MuakTiger/tactile-vision/logs/compare/20260928_132213_181_indoor.png

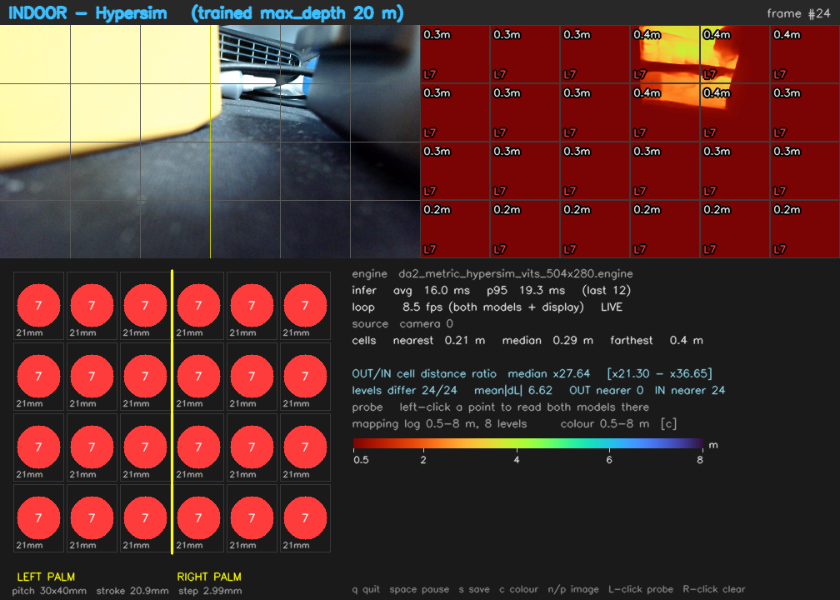
logs/compare/20260928_132213_181_indoor.png
