MuakTiger/tactile-vision/logs/compare/20260928_132213_873_outdoor.png

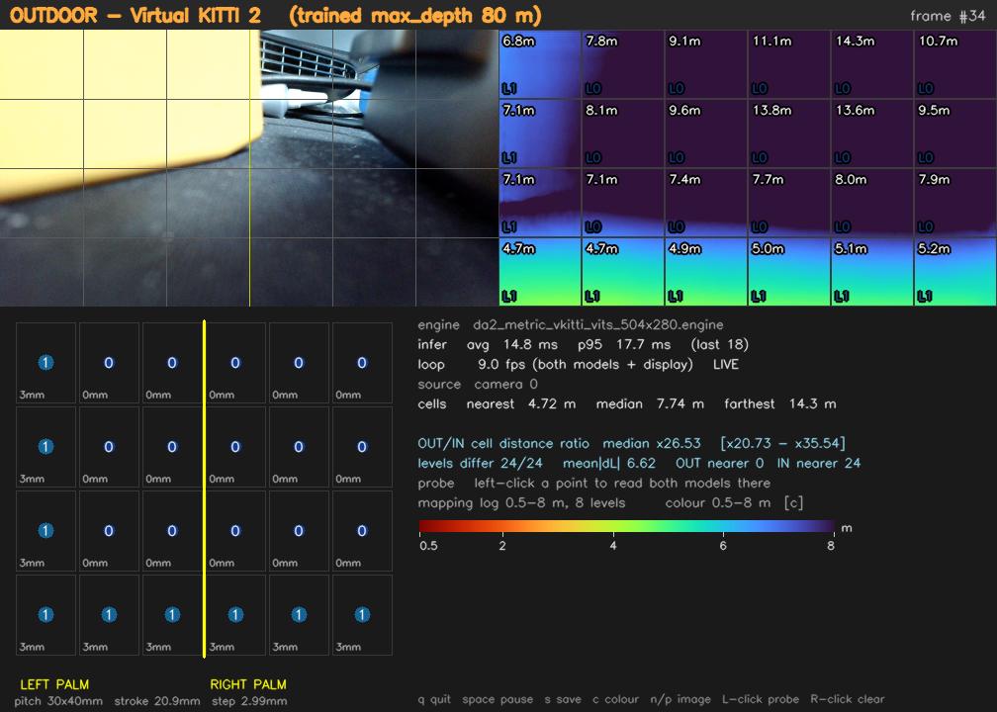
logs/compare/20260928_132213_873_outdoor.png
