MuakTiger/tactile-vision/docs/experiment_notebook_2026-10.html

졸업논문 실험 · 10/15(목) ~ 10/17(토) · 제출 10/20(화)

# 촉각비전 실험 노트

반응 시간, 거리, 핀 영점, 보행 실험의 준비물·절차·명령어·기록 형식을 날짜 순서로 모았어요. 체크 표시는 이 기기의 브라우저에만 남아요.

## 일정

언제 | 할 일 | 완료 기준
목 낮 | 교수님 메일, 토요일 보조자·장소, 주문·구입 | 메일 발송, 보조자 확정
목 20:00~ | 반응 시간 | 슬로모션 원본 3개(30회), 로그 사본
금 오후 17:30 전 | 거리 (실내·실외) | 실내·실외 각 6거리 사진
금 저녁 | 핀 영점, 토요일 준비 | 기록 240줄, 보정 파일 저장, SSH 연습
토 | 정지 감지, 보행 18회 | 정지 로그 20개, 기록표 18줄
일~화 | 분석·작성 | 10/20 제출

- 설정은 그대로 둬요. 토요일까지 바꾸는 건 핀 보정 파일 하나뿐이에요. 단계 수·필터·거리 범위는 손대지 않아요.
- 원본은 지우지 않아요. 영상·사진·로그는 날짜별 폴더에 그대로 둬요.
- 눈을 가리고 걸을 때는 보조자가 꼭 옆에 있어야 해요.

목 낮 · 수업 중과 하교길

## 연락과 준비물

- 지도교수님께 확인 메일 보내기 — 1인 보행 실험의 IRB 처리, 양식 1번의 분량·제출 형식
- 토요일 보조자 1명 확정 — 시간과 장소까지
- 토요일 복도 확정 — 10 m × 2.4 m 안팎, 계단·문턱 없는 곳, 사용 허락
- 디지털 캘리퍼스 주문 — 금속 몸체, 0.01 mm 표시, 깊이 막대가 있는 것. 금요일 저녁 전에 받을 수 있게
- 접이식 흰지팡이 주문 — 토요일 전에 못 받으면 곧은 막대(명치 높이, 약 120~130 cm)로 대신하고 그렇게 적어요
- 줄자 5 m 이상
- 골판지 큰 것 여러 장, 빈 상자 높이 45 cm 안팎
- 검은 종이나 검은 매직, 마스킹테이프, 끈, 수면 안대

목 20:00~ · 집 · 혼자

## 반응 시간 엔드투엔드

판이 카메라 앞에 나타나거나 사라진 뒤, 핀이 움직이기 시작하기까지와 목표 높이에 닿기까지 걸린 시간을 240 fps 영상으로 잽니다.

완료 기준슬로모션 원본 3개(10회씩, 모두 30회), 로그 사본 1개, 메모(벽까지 거리, 시작 단계)

### 준비물

- 장치 일체 — LiPo 2개와 보조배터리 충전
- 검은 판 40×60 cm와 끈 — 골판지에 검은 종이를 붙이거나 매직으로 칠해요
- 아이폰(슬로모션 240 fps)과 폰 거치대
- 30 cm 자, 기준선을 표시할 막대, 마스킹테이프

왼손

012678121314181920

오른손

34591011151617212223

장치 화면의 24칸. 재는 핀은 칸 9예요. 화면에서 위로부터 둘째 줄, 왼쪽부터 넷째 칸(오른손 첫 열)이에요. 0.5 m 앞에서 이 칸의 위쪽 경계는 렌즈보다 약 9 cm 높아요.

### 절차

1. 장치 점검
  시험 다섯 묶음이 모두 통과하고 핀이 한 번 오르내리면 돼요. 마지막 줄(코드 버전)은 메모해요.

cd ~/tactile-vision
PY=~/sensory_substitution/venv/bin/python
for t in tools/test_mapping.py tools/test_protocol.py tools/test_scene.py tools/test_switch.py tools/test_firmware.py; do $PY -B $t | tail -1; done
$PY -B tools/servo_updown_test.py --cycles 1
git log -1 --format='%h %ad %s' --date=short
  복사
2. 장치와 판 놓기
  장치를 책상에 고정하고 카메라가 먼 벽을 보게 해요. 벽까지 4 m 이상이면 가운데 칸이 단계 0에서 시작해요. 더 가까우면 시작 단계만 메모하면 돼요.
  판은 끈에 매달아, 떨어뜨리면 렌즈 앞 0.5 m에서 화면 가운데를 가리고 멈추게 끈 길이를 맞춰요.
3. 0 ms 기준선 표시
  판이 지나가는 옆에 막대를 세우고 렌즈 높이 + 9 cm에 테이프를 붙여요. 판 아래 끝이 이 선을 지나는 프레임이 0 ms예요. 내릴 때와 올릴 때 같은 선을 써요. 막대는 장치 카메라 화면 밖에 둬요.
4. 폰 놓기
  슬로모션(240 fps)으로 두고, 패드 뒤 위쪽에서 패드 너머로 판이 보이게 고정해요. 칸 9 핀이 크게 보이고 판 아래 끝과 기준선이 같은 화면에 들어오면 돼요. 핀 옆에 자를 세우고 조명은 밝게 해요.
5. 장치 실행 (확인 화면 없이)
  핀이 움직여요. 손을 패드에서 떼세요.

$PY -B run.py
  복사
6. 녹화 1 — 10회
  녹화 시작 → [판 내리기 → 3초 → 판 올리기 → 5초] × 10 → 녹화 정지
7. 녹화 2 — 10회
  같은 방법으로 10회.
8. 녹화 3 — 10회
  같은 방법으로 10회.
9. 끄고 로그 복사
  터미널에서 Ctrl+C를 누르면 핀이 천천히 내려가요. 그다음 로그를 다른 이름으로 복사해요.

cp logs/metrics.csv logs/metrics_$(date +%m%d_%H%M)_latency.csv
  복사
10. 영상 원본 옮기기, 메모
  케이블로 아이폰의 원본 파일(DCIM 폴더)을 그대로 복사해요. 일반 속도로 변환된 파일은 쓰지 않아요.
  메모: 벽까지 거리, 시작 단계, 설정은 '보정 전(24칸 372/232)'.

#### 주의

- 확인 화면(--debug)을 켜면 초당 9.4프레임으로 느려져요. 이 실험은 화면 없이 해요.
- run.py는 실행할 때마다 logs/metrics.csv를 새로 써요. 끝나면 바로 복사해요.
- 핀 영점 보정 전에 재도 괜찮아요. 영점과 최대를 같은 만큼 옮기는 보정이라 움직이는 시간은 그대로예요.

금 오후 · 해 지기 전(17:30까지) · 혼자 가능

## 거리 정확도

장치 카메라로 찍은 사진에서 모델이 추정한 거리를, 줄자로 잰 실제 거리와 비교합니다. 같은 사진에 실내·실외 모델을 둘 다 돌려 모델별 배율을 구해요. 분석은 사진만 있으면 나중에 할 수 있어요.

완료 기준실내 6거리 + 실외 6거리, 거리마다 숫자 종이 1장 + 판 3장 (모두 48장)

### 준비물

- C920(장치에 달린 그 카메라)과 노트북
- 판 50×70 cm 이상 — 무늬 없는 골판지 면
- 줄자, 마스킹테이프, 거리 숫자 종이(0.5 · 1 · 1.5 · 2 · 3 · 4 · 6 · 8)
- 카메라를 1.0 m 높이에 둘 받침 — 의자 위에 상자를 쌓아도 돼요

### 절차

1. 카메라 설정
  C920을 노트북에 꽂고 윈도 카메라 앱의 Pro 모드에서 초점을 가장 먼 쪽 끝으로 고정해요. 자동 초점은 끄고, 사진 비율은 16:9(1280×720 또는 1920×1080)로 해요.
  촬영하는 동안 초점은 건드리지 않아요. 가까운 판이 조금 흐린 건 정상이에요. 장치도 같은 초점이에요.
2. 카메라 놓기
  렌즈 높이 1.0 m, 수평, 정면. 렌즈 바로 아래 바닥을 0으로 하고 거리마다 바닥에 테이프를 붙여요. 거리는 렌즈 앞면에서 판 앞면까지예요.
3. 실내 (복도) — 0.5 · 1 · 1.5 · 2 · 3 · 4 m
  거리마다 숫자 종이를 판에 대고 1장 → 종이를 떼고 판만 3장. 사진 사이에는 판을 들었다가 다시 놓아요. 판 가운데가 렌즈 높이에 오고 카메라를 똑바로 보게 해요.
4. 실외 (넓은 보도·광장) — 1 · 2 · 3 · 4 · 6 · 8 m
  같은 방법으로 찍어요. 판이 바람에 흔들리지 않게 잡아 두세요.
5. 정리
  실내·실외 폴더로 나누고 장소, 시각, 날씨를 메모해요. 보조자가 있으면 실외에서 판 대신 사람이 같은 거리에 서서 3장씩 더 찍어요(선택).

#### 주의

- 꼭 장치의 C920으로 찍어요. 다른 카메라는 화각이 달라서 거리 배율도 달라져요.
- 판이 작으면 먼 거리에서 칸 넓이의 10%를 못 채워, 장치가 쓰는 칸 대표 거리에 잡히지 않아요. 50×70 cm보다 작게 하지 않아요.
- 10/12~13에 찍은 영상은 실제 거리 기록이 없으면 쓰지 않아요.
- 노트북에서 초점이 고정되지 않으면 실내만 젯슨과 모니터로 찍어 두세요(s 키로 저장, 초점 0 자동 고정). 실외 방법은 그다음에 정해요.

cd ~/tactile-vision
~/sensory_substitution/venv/bin/python -B tools/cam_raw.py --size 1280x720

복사

금 저녁 · 집 · 혼자

## 핀 영점 보정

같은 지령에서 24핀의 높이가 얼마나 다른지 재고, 핀마다 영점 tick을 옮겨 맞춘 뒤 다시 잽니다.

완료 기준보정 전·후 각각 24핀 × 단계 0·7 × 5회 (기록 240줄), 보정 파일 저장과 백업

### 준비물

- 디지털 캘리퍼스 — 켜고 턱을 닫은 상태에서 0으로 맞추기
- 기록지 2장(보정 전·후) — 핀 0~23 줄, 5회 × (단계 0, 단계 7) 칸

### 재는 법

핀이 튀어나왔을 때 (+)

캘리퍼스를 세워 본체 끝면을 핀 윗면에 얹고, 깊이 막대를 핀 바로 옆 패드 표면까지 내려 읽어요.

핀이 패드보다 낮을 때 (−)

끝면을 패드 표면에 얹고 깊이 막대를 핀 윗면까지 내려 읽은 뒤 −를 붙여요.

매번 같은 자세로, 0번부터 23번까지 같은 순서로 재요.

### 절차

1. 보정 파일 백업

cd ~/tactile-vision
PY=~/sensory_substitution/venv/bin/python
cp calib/servo_calib.json calib/servo_calib_backup_$(date +%m%d_%H%M).json
  복사
2. 보정 전 측정 — 5회
  24칸을 공통값(372/232)으로 움직여요. 보정 파일은 건드리지 않아요. 핀이 내려가 있는 6분 동안 24핀(단계 0)을, 올라가 있는 6분 동안 24핀(단계 7)을 재요. 이걸 5번 반복해요.

$PY -B tools/servo_updown_test.py --home 372 --span 140 --cycles 5 --hold 360
  복사
3. 핀마다 영점 맞추기

$PY -B tools/calibrate_pins.py --step 1
  복사
  n p
  다음·이전 채널 (또는 0~9, a~n로 바로 고르기)
  g
  영점 위치로 이동 → 캘리퍼스로 재기
  k j
  1 tick씩 이동. 역방향 조립이라 k는 핀이 내려가고 j는 올라가요
  h
  0.00 mm(±0.05)가 되면 영점 저장. 누른 키와 횟수를 적어 둬요
  G → m
  최대 위치로 가서 같은 키를 같은 횟수만큼 누른 뒤 최대 저장. 스트로크가 그대로 유지돼요
  t
  24칸을 다 하면 전체 스윕으로 눈 확인
  s → q
  저장하고 끝내기
4. 보정 후 측정 — 5회
  이번에는 저장한 보정 파일 값으로 움직여요. 재는 방법은 2번과 같아요.

$PY -B tools/servo_updown_test.py --cycles 5 --hold 360
  복사
5. 기록지 사진
  보정 전·후 두 장을 찍어 둬요. 나중에 분석용 CSV(phase, pin, rep, zero_mm, top_mm, home_tick)로 옮겨요.

#### 주의

- 핀이 움직이는 동안 손을 패드에 두지 않아요.
- 최대 위치를 옮길 때 기어가 걸리는 소리가 나면 멈추고, 그 칸은 메모만 해요.
- 6분 안에 24핀을 다 못 재면 --hold 값(초)을 늘려요.

### 토요일 준비 (같은 날 밤)

- SSH 연습 — 젯슨과 노트북을 휴대폰 핫스팟에 연결 → 젯슨에서 hostname -I로 IP 확인 → 노트북 PowerShell에서 ssh june@IP. 접속되면 성공
- 장애물 ① 빈 상자 (높이 45 cm)
- 장애물 ② 사람 크기 판 (골판지, 높이 170 cm × 폭 45 cm, 넘어지지 않게 받침)
- 장애물 ③ 머리 높이 판 (골판지 약 60×40 cm, 아랫면 145 cm) — 매달 방법까지 정하기. 지팡이에 걸리는 받침이 없어야 해요
- 장애물 ④ 의자
- 수면 안대, 흰지팡이(또는 막대), 초시계(휴대폰)
- 배터리 충전 — LiPo 2개, 보조배터리, 노트북, 휴대폰

토 · 복도 · 보조자 1명

## 1인 장애물 보행

눈을 가리고 10 m 코스를 걸을 때 지팡이만(C), 장치만(D), 둘 다(C+D) 쓴 경우의 완주 시간과 충돌을 비교합니다. 그 전에, 걷지 않고 선 채로 장애물마다 장치가 몇 단계로 표시하는지 잽니다.

완료 기준정지 감지 로그 20개, 보행 18회 기록표, 묶음 로그 2개, 영상, 사진(장치 착용·코스)

참여자 (본인)

안대, 장치 착용, 걷기

보조자

배치 바꾸기, 초시계, 뒤따르며 촬영, 위험하면 멈춰 세우기

### 코스와 배치

폭 2.4 m, 길이 10 m. 출발선·도착선과 2.5 · 4.5 · 6.5 · 8.5 m 위치를 바닥에 테이프로 표시해요. 복도가 짧거나 좁으면 비율대로 줄이고 실제 크기를 적어요.

배치 | ① 상자 | ② 사람 판 | ③ 머리 판 | ④ 의자
L1 | 2.5 m 왼쪽 | 4.5 m 가운데 | 6.5 m 오른쪽 | 8.5 m 오른쪽 벽
L2 | 4.5 m 오른쪽 | 8.5 m 왼쪽 | 2.5 m 가운데 | 6.5 m 왼쪽 벽
L3 | 6.5 m 가운데 | 2.5 m 오른쪽 | 8.5 m 왼쪽 | 4.5 m 오른쪽 벽

L1

L2

L3

왼쪽·오른쪽은 걷는 사람 기준이에요. 그림의 위쪽 벽이 왼쪽 벽이고, 점선 테두리(③)는 매달린 판이에요.

### 진행 순서

1. 코스 설치
  바닥에 테이프로 표시하고, L1 배치를 한 번 놓아 봐요.
2. 젯슨 접속
  노트북에서 SSH로 접속한 뒤:

cd ~/tactile-vision
PY=~/sensory_substitution/venv/bin/python
  복사
3. 정지 감지 시험 (약 30분, 걷지 않음)
  장애물 하나를 코스 가운데에 두고, 장치를 착용한 채 장애물 앞 4 · 3 · 2 · 1.5 · 1 m에 서서 8초씩 실행해요. 핀은 움직이지 않아요. 위치마다 로그를 바로 복사해요.

$PY -B run.py --no-hw --duration 8
cp logs/metrics.csv logs/static_box_4m.csv
  복사
  파일 이름의 장애물(box · panel · head · chair)과 거리를 바꿔 가며 20번 해요. 예: static_head_1.5m.csv

장애물 | 4 m | 3 m | 2 m | 1.5 m | 1 m
① 상자box
② 사람 판panel
③ 머리 판head
④ 의자chair

4. 기준 속도
  눈을 뜨고 장애물 없이 3번 걸어요. 세 시간의 평균이 기준 시간(baseline_s)이에요.
5. 연습 (코스 밖에서)
  지팡이 이점 접촉법 10분, 장치 10분, 둘 다 5분. 실제로 연습한 시간을 적어요.
6. 장치 켜고 묶음 1 (1~9번)
  이렇게 켜면 SSH가 끊겨도 계속 돌아요.

setsid -f nohup $PY -B run.py > /tmp/tv_run.log 2>&1 < /dev/null
  복사
7. 쉬는 동안 끄고 로그 복사

kill -TERM $(pgrep -f '[r]un\.py'); sleep 3
cp logs/metrics.csv logs/exp3_block1.csv
  복사
8. 다시 켜고 묶음 2 (10~18번), 끝나면 끄고 복사

setsid -f nohup $PY -B run.py > /tmp/tv_run.log 2>&1 < /dev/null
# 18번까지 끝나면
kill -TERM $(pgrep -f '[r]un\.py'); sleep 3
cp logs/metrics.csv logs/exp3_block2.csv
  복사
9. 마무리 사진
  장치를 착용한 모습, 코스 전경, 기록표.

### 한 번의 시행

1. 참여자는 안대를 쓰고 출발선 뒤에서 벽 쪽을 보고 서 있어요. 배치를 보지 않아요.
2. 보조자가 순서표의 배치로 장애물을 옮기고, 조건에 맞게 지팡이를 주거나 거둬요.
3. "출발" — 보조자가 초시계를 누르고 뒤따르며 촬영해요.
4. 몸이 도착선을 넘으면 "도착" — 초시계를 멈춰요.
5. 장애물별 충돌을 적어요. 몸이나 장치가 닿으면 1회, 보조자가 멈춰 세워도 1회예요. 지팡이 끝이 닿은 건 세지 않아요.
6. 30초 쉬고 다음 시행으로 넘어가요.

C+D에서 손: 지팡이는 주로 쓰는 손에, 다른 손 손바닥은 패드에 두고 필요하면 좌우로 옮겨 훑어요. 정한 방법을 그대로 적어요.

### 시행 순서표

완료 | 순서 | 배치 | 조건
묶음 1
| 1 | L2 | C+D둘 다
| 2 | L1 | C지팡이만
| 3 | L3 | D장치만
| 4 | L2 | C지팡이만
| 5 | L3 | C+D둘 다
| 6 | L1 | D장치만
| 7 | L3 | C지팡이만
| 8 | L2 | D장치만
| 9 | L1 | C+D둘 다
묶음 2
| 10 | L3 | D장치만
| 11 | L2 | C지팡이만
| 12 | L1 | D장치만
| 13 | L3 | C지팡이만
| 14 | L2 | C+D둘 다
| 15 | L1 | C지팡이만
| 16 | L3 | C+D둘 다
| 17 | L2 | D장치만
| 18 | L1 | C+D둘 다

같은 배치나 같은 조건이 연달아 나오지 않게 미리 무작위로 정한 순서예요. 묶음마다 조건 3가지 × 배치 3가지가 한 번씩 들어 있어요.

### 기록표 (종이)

순서 | 배치 | 조건 | 시간(초) | ① 상자 | ② 사람 판 | ③ 머리 판 | ④ 의자 | 벽 | 메모
예 | L2 | C+D | 38.4 | 0 | 0 | 1 | 0 | 0 | 칸 쓰는 법 예시

분석할 때 쓰는 열: participant(P1), cond(cane · device · cane_device), block, trial, layout, time_s, col_low(①), col_panel(②), col_head(③), col_side(④), col_wall(벽), baseline_s

#### 안전

- 보조자는 늘 1 m 안에서 뒤따르고, 멈춤 신호("정지")를 미리 정해요.
- 장애물은 가벼운 골판지로 해요. 머리 높이 판은 부딪히면 밀려나게 끈으로 매달고 모서리는 테이프로 감싸요.
- 장치만(D) 쓸 때는 지팡이가 없어 45 cm 상자에 걸려 넘어질 수 있어요. 보조자가 특히 가까이 붙어요.
- 시작 전에 LiPo 전압과 배선을 확인하고, 뜨거워지면 바로 멈춰요.
- IRB 답이 '안 된다'면 정지 감지 시험만 하고 보행은 하지 않아요.

## 기록 규칙

- 원본(영상·사진·로그)은 지우거나 덮어쓰지 않아요. '날짜_실험' 폴더에 그대로 둬요. 예: 1015_반응시간
- run.py는 실행할 때마다 logs/metrics.csv를 새로 써요. 끝나면 바로 다른 이름으로 복사해요.
- 종이 기록은 사진을 찍어 두세요. 나중에 분석용 CSV로 옮길 때 써요.
- 그날 쓴 설정을 메모해요: 코드 버전(git log -1), 보정 전/후, 장소, 시각.
- 분석 폴더의 make_example_data.py는 다시 돌리지 않아요. 실측 CSV를 덮어써요.
- 얼굴이 나온 영상·사진은 공개 저장소에 올리지 않아요.

### 이번에 하지 않는 것

- 단계 수(8단계)·필터·거리 범위 바꾸기
- 손바닥 높이 구별 실험, 카메라 체커보드 캘리브레이션
- 실외 보행, 여러 명 참여
- 거리 보정 계수를 장치 설정에 넣기 (분석에서만 써요)

2026-10-15 작성 · 체크 표시는 이 기기의 브라우저에만 저장돼요.

체크 모두 지우기
