MuakTiger/tactile-vision/(commit log)

2026-10-05 촉각 비전 장치 v3: 카메라 → 깊이(Depth Anything V2 metric)·실내외 판별·YOLO26n → Pico → 24핀
    - 젯슨 파이프라인(run.py, src/tactile_vision), Pico 펌웨어 v3(박자 적용, 위험도 진동, 종료·끊김 시 천천히 맨 아래)
    - 캘리브레이션(역방향 조립 home 372 / max 232), 시험·도구, 실행 로그
    - 모델 가중치·엔진은 포함하지 않음 (README 참고)
    [live_camera_60s_metrics.csv, metrics_2026-09-25.csv, metrics_2026-10-05_1909_before_invert.csv, metrics_2026-10-05_1925_inverted.csv, photo_switch_metrics.csv, probes.csv, servo_calib.json, servo_calib_default_geometry_2026-09-22.json]
2026-10-05 MIT 라이선스 추가 (vendor/depth_anything_v2는 Apache-2.0 유지)
    - README: 라이선스 절, 펌웨어 실기 확인 상태 갱신
2026-10-15 docs: 10/15~17 실험 노트 추가 (반응 시간·거리 정확도·핀 영점·1인 보행)
    브라우저로 여는 절차서: 준비물, 단계별 절차와 명령어, 기록 형식, 보행 배치 L1~L3,
    미리 정한 시행 순서(시드 20261017). 체크 표시는 브라우저에만 저장된다.
    코드와 설정은 바꾸지 않음.
2026-10-17 ground-scale: 실외 땅 기준 거리 환산 + 실내 모델 보정
    거리 사진 120장(렌즈 0.70 m, 줄자 기준) 검증 결과에 따라:
    - 실외: metric VKITTI2 대신 상대깊이(Depth-Anything-V2-Small) + 땅 기준 환산.
    화면 아래 땅 줄의 거리를 카메라 높이·기울기·초점거리로 계산해 프레임마다 배율을 정함
    (src/tactile_vision/ground.py). 실외 MAPE 519% -> 21.1%.
    - 실내: depth.indoor_offset_m = -0.44 (MAPE 34% -> 9.5%, 장소 교차).
    - 설정: depth.outdoor_kind(metric|ground), depth.indoor_offset_m, ground 섹션.
    기본값(섹션 없음)은 예전 동작.
    - tools/build_engine.py --relative, vendor dpt.py max_depth=None = 상대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
2026-10-17 ground-scale: d_far 실내 8 m / 실외 20 m (사용자 결정)
    scene.far_indoor_m 4 -> 8, far_outdoor_m 8 -> 20. 핀이 올라오기 시작하는 거리
    실내 6.56 m, 실외 15.4 m. 거리 사진은 8 m까지만 검증. README 반영. 시험 240항목 통과.
2026-10-17 tools: 구동 지연 측정(화면 흰·검 전환 + 칸 9 핀) 도구와 2026-10-17 기록 3개
    깊이 계산 없이 칸 9를 0 <-> 7단계로 바꿔 초당 15회 보내고, 바꾸는 프레임을
    보낸 직후 창을 흰색(올림)/검은색(내림)으로 바꾼다. 폰 슬로모션으로 화면과 핀을
    함께 찍어 전송 -> 핀 시작·도착 시간을 잰다. 분석은 논문 저장소 latency_flip.py.
    [latency_flip_1017_2056.csv, latency_flip_1017_2058.csv, latency_flip_1017_2103.csv]
2026-10-17 핀 영점 보정: 칸별 0단계 맞춤 도구와 보정값을 기준으로 (파일·펌웨어·젯슨 기본값)
    - tools/pin_zero_gui.py: 창에서 24칸을 골라 0단계 높이를 1 tick씩 맞춤.
    home·max를 같이 옮겨 스트로크 유지, 보정 전(372/232) 대비 ±80 tick 한계, Enter 저장 + Pico 반영
    - calib/servo_calib.json: 2026-10-17 사용자 보정값(보정 전 대비 -55 ~ +80 tick).
    보정 전 파일 servo_calib_before_zero_1017_2203.json, 1차 조정 뒤 _2210.json
    - 펌웨어 tactile_core.h ZERO_SHIFT_DEFAULT: Pico가 켜질 때(젯슨 연결 전)도 칸별 보정 위치.
    PC 하네스 기본 빌드는 -DTV_UNIFORM_DEFAULTS로 기존 동작 시험 유지
    -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
    [servo_calib.json, servo_calib_before_zero_1017_2203.json, servo_calib_before_zero_1017_2210.json]
